Alarm-Siren/Feedback-Box/hardware/Feedback-Box-3Drender-8A-back.jpg

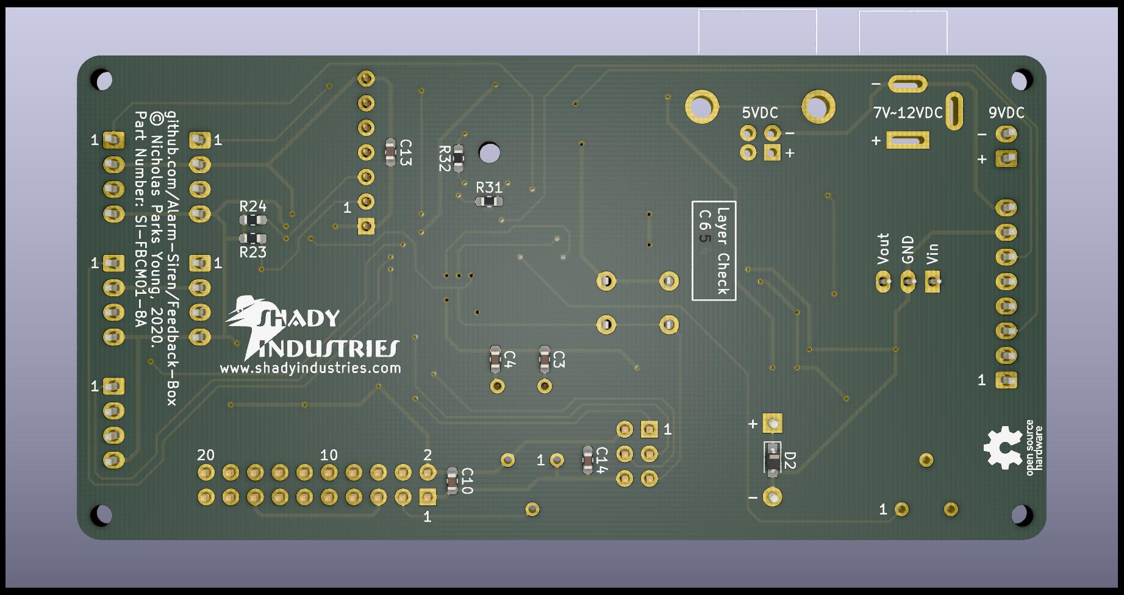
hardware/Feedback-Box-3Drender-8A-back.jpg
