Alarm-Siren/Feedback-Box/hardware/Feedback-Box-3Drender-8A-front.jpg

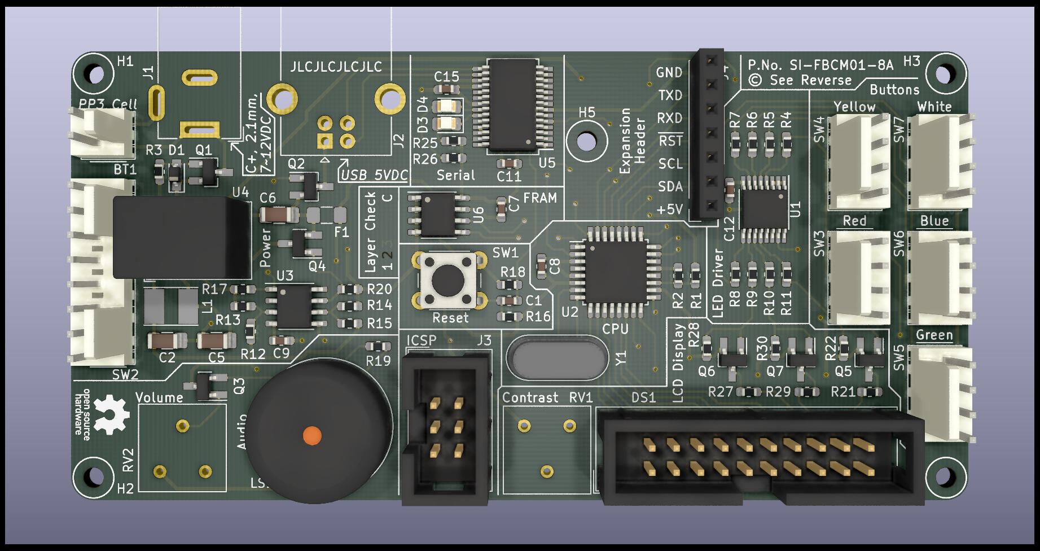
hardware/Feedback-Box-3Drender-8A-front.jpg
