Alarm-Siren/Feedback-Box/hardware/Parts List.xlsx

Reference | Manufacturer | Mft's Part Number | Qty/unit | Total Qty | Price/each (£) | Subtotal (£) | Mouser Part No | Farnell Part No | Misc. Part Link | Footprint | Description
BT1 | Bulgin | BX0023 | 1 | 5 | £4.48 | £22.40 | 122-BX0023 | 1184193 |  | n/a | PP3 (9V) battery holder, panel-mount, black, Flying Leads
BT1a | Molex | 22292021 | 1 | 5 | £0.33 | £1.64 | 538-22-29-2021 | 1360130 |  | Connector_Molex:Molex_KK-254_AE-6410-02A_1x02_P2.54mm_Vertical | Molex KK 254 Series, 2pin header, Wire-to-board, THT
BT1b | Molex | 22013027 | 1 | 5 | £0.06 | £0.32 | 538-22-01-3027 | 1462825 |  | n/a | Molex KK Connector Housing 2pin w/Mating flange & polarizing ribs
BT1c, SW2c | Molex | 08520123 | 44 | 220 | £0.02 | £3.98 | 538-08-52-0101-CT | 2888993 |  | n/a | Molex KK Crimp Contacts, 30-22AWG, Phospher Bronze, Cut Strip
C1, C7-C15 | Wurth Elektronik | 885012206071 | 10 | 50 | £0.03 | £1.40 | 710-885012206071 | 2495173 |  | Capacitor_SMD:C_0603_1608Metric_Pad1.05x0.95mm_HandSolder | Capacitor MLCC 100nF, X7R, 25V, +/-10%, SMD 0603
C2, C6 | Taiyo Yuden | UMK316BBJ106KL-T | 2 | 10 | £0.14 | £1.39 | 963-UMK316BBJ106KL-T |  |  | Capacitor_SMD:C_1206_3216Metric_Pad1.42x1.75mm_HandSolder | Capacitor MLCC 10uF, X5R, 50V, +/-10%, SMD 1206
C3, C4 | AVX | 06035C220JAT2A | 2 | 10 | £0.07 | £0.66 | 581-06035C220JAT2A | 2332643 |  | Capacitor_SMD:C_0603_1608Metric_Pad1.05x0.95mm_HandSolder | Capacitor MLCC 22pF, X7R, 50V, +/-5%, SMD 0603
C5 | Taiyo Yuden | UMK316AB7475KL-T | 1 | 5 | £0.24 | £1.20 | 963-UMK316AB7475KL-T |  |  | Capacitor_SMD:C_1206_3216Metric_Pad1.42x1.75mm_HandSolder | Capacitor MLCC 4.7uF, X7R, 50V, +/-10%, SMD 1206
D1 | ON Semiconductor | MM3Z7V5ST1G | 1 | 5 | £0.09 | £0.46 | 863-MM3Z7V5ST1G | 2441322 |  | Diode_SMD:D_SOD-323_HandSoldering | Single Zener Diode, 7.5V, 300mW, SMD SOD-323
D2 | ON Semiconductor / Fairchild | SS16HE | 1 | 5 | £0.08 | £0.39 | 512-SS16HE | 2822565 |  | Diode_SMD:D_SOD-323_HandSoldering | Schottky Rectifier Diode, Vmax=60V, Imax=1A, Vf=680mV, SMD SOD-323
D3 | Lite-On | LTST-C171KRKT | 1 | 5 | £0.22 | £1.08 | 859-LTST-C171KRKT |  |  | LED_SMD:LED_0805_2012Metric_Pad1.15x1.40mm_HandSolder | Standard Red LED, 55mCD, SMD 0805
D4 | Lite-On | LTST-C171KGKT | 1 | 5 | £0.22 | £1.08 | 859-LTST-C171KGKT |  |  | LED_SMD:LED_0805_2012Metric_Pad1.15x1.40mm_HandSolder | Standard Green LED, 55mCD, SMD 0805
DS1 | Newhaven Displays | NHD-0216K1Z-FS(RGB)-FBW-REV1 | 1 | 5 | £10.55 | £52.75 | 763-0216K1Z-FS-FBWR1 |  |  | n/a | Character LCD 16x2, RGB Backlight, Parallel access, THT
DS1a | Amphenol | T821120A1S100CEU | 1 | 5 | £0.25 | £1.24 |  | 2215309 |  | Connector_IDC:IDC-Header_2x10_P2.54mm_Vertical | IDC Socket 2.54mm pitch, 2x10, Vertical, THT
DS1b | Amphenol | T812120A100CEU | 1 | 5 | £0.23 | £1.15 |  | 2215236 |  | n/a | IDC Plug 2.54mm pitch, 2x10, Vertical
DS1c, SW2a | Molex | 22272081 | 2 | 10 | £0.34 | £3.37 | 538-22-27-2081 | 9731180 |  | Connector_Molex:Molex_KK-254_AE-6410-08A_1x08_P2.54mm_Vertical | Molex KK 254 Series, 8pin header, Wire-to-board, THT
DS1d, SW2b | Molex | 22013087 | 2 | 10 | £0.21 | £2.06 | 538-22-01-3087 | 2396394 |  | n/a | Molex KK Connector Housing 8pin w/Mating flange & polarizing ribs
DS1e | Molex | 22272061 | 1 | 5 | £0.33 | £1.65 | 538-22-27-2061 | 9731172 |  | n/a | Molex KK 254 Series, 6pin header, Wire-to-board, THT
DS1f | Molex | 22013067 | 1 | 5 | £0.19 | £0.96 | 538-22-01-3067 | 1654529 |  | n/a | Molex KK Connector Housing 6pin w/Mating flange & polarizing ribs
F1 | Bel Fuse | 0ZCJ0025AF2E | 1 | 5 | £0.09 | £0.43 | 530-0ZCJ0025AF2E | 2834884 |  | Fuse:Fuse_1206_3216Metric_Pad1.42x1.75mm_HandSolder | PTC Resettable Fuse, Hold 250mA, Trip 500mA, 24VDC, SMD 1206
J1 | Wurth Elektronik | 694106301002 | 1 | 5 | £0.70 | £3.50 | 710-694106301002 | 2472149 |  | Connector_BarrelJack:BarrelJack_Wuerth_6941xx301002 | Barrel Jack Socket, ID 2.1mm, OD 5.5mm, THT
J2 | CUI Devices | UJ2-BH-1-TH | 1 | 5 | £0.42 | £2.09 | 490-UJ2-BH-1-TH |  |  | Connector_USB:USB_B_OST_USB-B1HSxx_Horizontal | USB-B Socket, THT
J3 | Amphenol | T821106A1S100CEU | 1 | 5 | £0.20 | £1.00 |  | 2215302 |  | Connector_IDC:IDC-Header_2x03_P2.54mm_Vertical | IDC Socket 2.54mm pitch, 2x3, Vertical, THT
J4 | Samtec | SSW-107-01-T-S | 1 | 5 | £0.73 | £3.67 | 200-SSW10701TS | 2667434 |  | Connector_PinSocket_2.54mm:PinSocket_1x07_P2.54mm_Vertical | 1x07 2.54mm Square Header Recepticle, Vertical, THT
L1 | RECOM | RLS-126 | 1 | 5 | £0.47 | £2.34 | 919-RLS-126 |  |  | Inductor_SMD:L_Taiyo-Yuden_NR-40xx_HandSoldering | 12uH 0.8A Fixed Inductor, SMD
LS1 | CUI Devices | CVS-1508 | 1 | 5 | £2.29 | £11.45 | 490-CVS-1508 |  |  | Buzzer_Beeper:Buzzer_15x7.5RM7.6 | Loudspeaker, 300mW 8R, D15mm, THT
Q1-Q2, Q4-Q7 | ON Semiconductor / Fairchild | FDN340P | 6 | 30 | £0.26 | £7.68 | 512-FDN340P | 9846310 |  | Package_TO_SOT_SMD:SOT-23_Handsoldering | Mosfet Transistor, P-Channel, 2A, 20V, 0.06R, SMD SOT-23
Q3 | ON Semiconductor | MMBT2222ALT1G | 1 | 5 | £0.10 | £0.51 | 863-MMBT2222ALT1G | 1459098 |  | Package_TO_SOT_SMD:SOT-23_Handsoldering | Bipolar Transistor, NPN, 40V, 300MHz, 225mW, 600mA, SMD SOT-23
R1 | Yageo | RC0603FR-078K2L | 1 | 5 | £0.01 | £0.07 | 603-RC0603FR-078K2L | 9238590 |  | Resistor_SMD:R_0603_1608Metric_Pad1.05x0.95mm_HandSolder | Resistor 8.2kR, 100mW, 75V, +/-1%, SMD 0603
R12, R17, R20, R22, R28, R30 | Yageo | RC0603FR-0768KL | 6 | 30 | £0.01 | £0.42 | 603-RC0603FR-0768KL | 9238700 |  | Resistor_SMD:R_0603_1608Metric_Pad1.05x0.95mm_HandSolder | Resistor 68kR, 100mW, 75V, +/-1%, SMD 0603
R14 | Yageo | RC0603FR-0782KL | 1 | 5 | £0.01 | £0.07 | 603-RC0603FR-0782KL | 9238719 |  | Resistor_SMD:R_0603_1608Metric_Pad1.05x0.95mm_HandSolder | Resistor 82kR, 100mW, 75V, +/-1%, SMD 0603
R16 | Yageo | RC0603FR-0710KL | 1 | 5 | £0.01 | £0.07 | 603-RC0603FR-0710KL | 9238603 |  | Resistor_SMD:R_0603_1608Metric_Pad1.05x0.95mm_HandSolder | Resistor 10kR, 100mW, 75V, +/-1%, SMD 0603
R18, R25-R26, R31-R32 | Yageo | RC0603FR-071KL | 5 | 25 | £0.01 | £0.35 | 603-RC0603FR-071KL | 9238484 |  | Resistor_SMD:R_0603_1608Metric_Pad1.05x0.95mm_HandSolder | Resistor 1kR, 100mW, 75V, +/-1%, SMD 0603
R19 | Yageo | RC1210FR-0762RL | 1 | 5 | £0.12 | £0.61 | 603-RC1210FR-0762RL |  |  | Resistor_SMD:R_1210_3225Metric_Pad1.42x2.65mm_HandSolder | Resistor 62R, 500mW, 75V, +/-1%, SMD 1210
R2 | Yageo | RC0603FR-074K7L | 1 | 5 | £0.01 | £0.07 | 603-RC0603FR-074K7L | 9238565 |  | Resistor_SMD:R_0603_1608Metric_Pad1.05x0.95mm_HandSolder | Resistor 4.7kR, 100mW, 75V, +/-1%, SMD 0603
R23, R24 | Yageo | RC0603FR-073K3L | 2 | 10 | £0.01 | £0.14 | 603-RC0603FR-073K3L | 9238549 |  | Resistor_SMD:R_0603_1608Metric_Pad1.05x0.95mm_HandSolder | Resistor 3.3kR, 100mW, 75V, +/-1%, SMD 0603
R27 | Yageo | RC0603FR-07150RL | 1 | 5 | £0.01 | £0.07 | 603-RC0603FR-07150RL | 9238387 |  | Resistor_SMD:R_0603_1608Metric_Pad1.05x0.95mm_HandSolder | Resistor 150R, 100mW, 75V, +/-1%, SMD 0603
R3, R13, R15 | Yageo | RC0603FR-07100KL | 3 | 15 | £0.01 | £0.21 | 603-RC0603FR-07100KL | 9238727 |  | Resistor_SMD:R_0603_1608Metric_Pad1.05x0.95mm_HandSolder | Resistor 100kR, 100mW, 75V, +/-1%, SMD 0603
R4-R8, R21, R29 | Yageo | RC0603FR-07120RL | 7 | 35 | £0.01 | £0.49 | 603-RC0603FR-07120RL | 9238379 |  | Resistor_SMD:R_0603_1608Metric_Pad1.05x0.95mm_HandSolder | Resistor 120R, 100mW, 75V, +/-1%, SMD 0603
R9-R11 | Yageo | RC0603FR-070RL | 3 | 15 | £0.01 | £0.18 | 603-RC0603FR-070RL | 2309106 |  | Resistor_SMD:R_0603_1608Metric_Pad1.05x0.95mm_HandSolder | Resistor 0R, 100mW, 75V, +/-1%, SMD 0603
RV1-RV2 | Bourns | 3306F-1-103 | 2 | 10 | £0.28 | £2.79 | 652-3306F-1-103 | 1689844 |  | Potentiometer_THT:Potentiometer_Bourns_3386F_Vertical | Trimmer Potentiometer, 10kR, 6mm, 1 turn, Phillips-head, THT
SW1 | Omron | B3W-1000 | 1 | 5 | £0.47 | £2.33 | 653-B3W-1000 | 176986 |  | Button_Switch_THT:SW_PUSH_6mm | 6mm Tactile Switch, THT
SW2 | C&K | Y200AA2C203NQ | 1 | 5 | £12.06 | £60.30 | 611-Y200AA2C203NQ |  |  | n/a | Keylock Switch, DP3T, 4A 125V, Solder Lugs
SW3-SW7 | EG Starts | --- | 5 | 25 | £1.30 | £32.50 |  |  | https://www.amazon.co.uk/EG-Starts-Arcade-Buttons-Multicade/dp/B01N549IDL/ref=sr_1_16 | n/a | Assorted Colours of Illuminated Arcade-style Buttons, Solder Lugs
SW3a-SW7a | Molex | 22272041 | 5 | 25 | £0.24 | £5.92 | 538-22-27-2041 | 9731164 |  | Connector_Molex:Molex_KK-254_AE-6410-04A_1x04_P2.54mm_Vertical | Molex KK 254 Series, 4pin header, Wire-to-board, THT
SW3b-SW7b | Molex | 22013047 | 5 | 25 | £0.11 | £2.65 | 538-22-01-3047 | 2888913 |  | n/a | Molex KK Connector Housing 4pin w/Mating flange & polarizing ribs
U1 | Texas Instruments | TLC59208FIPWR | 1 | 5 | £1.30 | £6.50 | 595-TLC59208FIPWR |  |  | Package_SO:TSSOP-16_4.4x5mm_P0.65mm | LED Controller / Driver, 8 channel, I2C, SMD TSSOP-16
U2 | Microchip / Atmel | ATmega328p-AU | 1 | 5 | £1.50 | £7.50 | 556-ATMEGA328P-AU | 1715486 |  | Package_QFP:TQFP-32_7x7mm_P0.8mm | Microcontroller, 32K flash, 2K ram, SMD TQFP-32
U3 | Texas Instruments | LMV358IDR | 1 | 5 | £0.31 | £1.55 | 595-LMV358IDR | 3117235 |  | Package_SO:SOIC-8_3.9x4.9mm_P1.27mm | Rail-to-Rail Voltage Comparator, SMD SOIC-8
U4 | RECOM | R-78E5.0-0.5 | 1 | 5 | £2.06 | £10.30 | 919-R-78E5.0-0.5 | 2078564 |  | Converter_DCDC:Converter_DCDC_RECOM_R-78E-0.5_THT | DC-DC Voltage Regulator, Switching, Output 5V 500mA, THT
U5 | FTDI | FT232RL-REEL | 1 | 5 | £3.48 | £17.40 | 895-FT232RL | 1146032 |  | Package_SO:SSOP-28_5.3x10.2mm_P0.65mm | USB to Serial Interface IC, SMD SSOP-28
U6 | Cypress Semiconductor | FM24C16B-G | 1 | 5 | £1.24 | £6.20 | 877-FM24C16B-G | 2077748 |  | Package_SO:SOIC-8_3.9x4.9mm_P1.27mm | FRAM, 2KiB, I2C Interface, SMD SOIC-8
Y1 | IQD | LFXTAL027945Reel | 1 | 5 | £0.40 | £2.01 | 449-LFXTAL027945REEL |  |  | Crystal:Crystal_HC49-4H_Vertical | Parallel Crystal, 16MHz, 22pF, THT
 |  |  |  |  | Units Req'd | 5
 |  |  |  |  | Grand Total | £292.57
 |  |  |  |  | Per Unit | £58.51
