Alarm-Siren/Feedback-Box/hardware/Feedback-Box.kicad_pcb

## KiCad design hardware/Feedback-Box.kicad_pcb (2020-08-21)

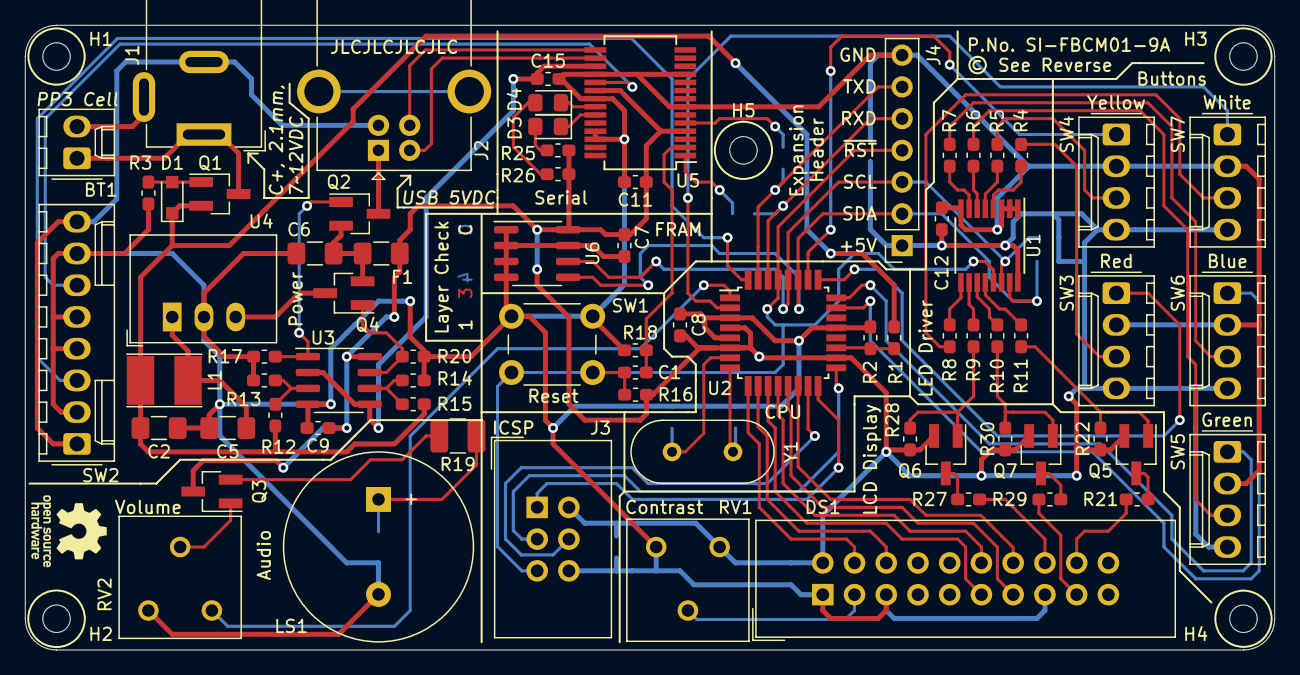
[picture p3: board Feedback-Box.kicad_pcb from above]

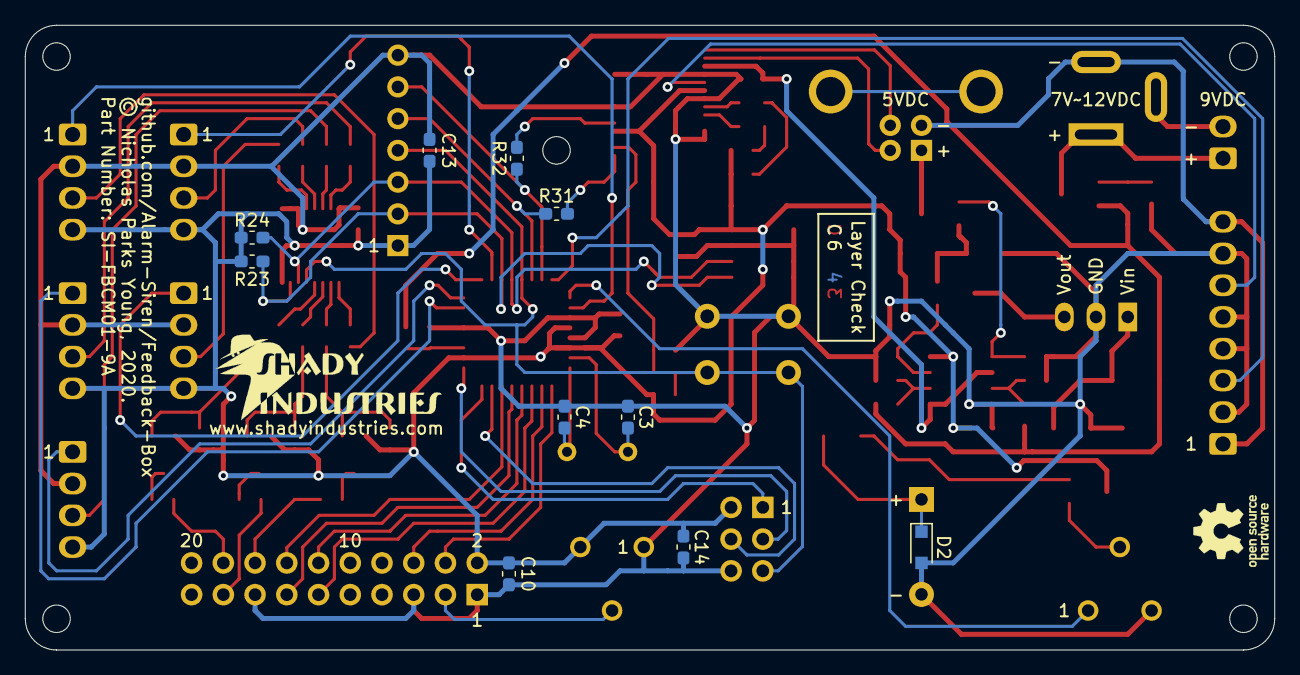
[picture p4: board Feedback-Box.kicad_pcb from below]

Board: 2 copper layers, 100.0 x 50.0 mm, 91 parts (12 on the bottom side), 76 nets.

Parts:
BT1: BX0023; Molex_KK-254_AE-6410-02A_1x02_P2.54mm_Vertical
C1, C7, C8, C9, C10, C11, C12, C13, C14, C15: 100n; C_0603_1608Metric_Pad1.05x0.95mm_HandSolder
C2, C6: 10u; C_1206_3216Metric_Pad1.42x1.75mm_HandSolder
C3, C4: 22p; C_0603_1608Metric_Pad1.05x0.95mm_HandSolder
C5: 4.7u; C_1206_3216Metric_Pad1.42x1.75mm_HandSolder
D1: MM3Z7V5ST1G; D_SOD-323_HandSoldering
D2: SS16HE; D_SOD-323_HandSoldering
D3: LTST-C171KRKT; LED_0805_2012Metric_Pad1.15x1.40mm_HandSolder
D4: LTSTS-C171KGKT; LED_0805_2012Metric_Pad1.15x1.40mm_HandSolder
DS1: NHD-0216K1Z-FS(RGB)-FBW-REV1; IDC-Header_2x10_P2.54mm_Vertical
F1: 0ZCJ0025AF2E; Fuse_1206_3216Metric_Pad1.42x1.75mm_HandSolder
G1: LOGO; SI-Logo-W20.3mm_H8.4mm
G2, G3: OSHW-Logo_5.7x6mm_SilkScreen
H1, H2, H3, H4, H5: MountingHole_2.2mm_M2
J1: 694106301002; BarrelJack_Wuerth_6941xx301002
J2: UJ2-BH-1-TH; USB_B_OST_USB-B1HSxx_Horizontal
J3: T821106A1S100CEU; IDC-Header_2x03_P2.54mm_Vertical
J4: SSW-107-01-T-S; PinSocket_1x07_P2.54mm_Vertical
L1: 12u; L_Taiyo-Yuden_NR-40xx_HandSoldering
LS1: CVS-1508; Buzzer_15x7.5RM7.6
Q1, Q2, Q4, Q5, Q6, Q7: FDN340P; SOT-23_Handsoldering
Q3: MMBT2222ALT1G; SOT-23_Handsoldering
R1: 8.2k; R_0603_1608Metric_Pad1.05x0.95mm_HandSolder
R2: 4.7k; R_0603_1608Metric_Pad1.05x0.95mm_HandSolder
R3, R13, R15: 100k; R_0603_1608Metric_Pad1.05x0.95mm_HandSolder
R4, R5, R6, R7, R8, R21, R29: 120; R_0603_1608Metric_Pad1.05x0.95mm_HandSolder
R9, R10, R11: 0; R_0603_1608Metric_Pad1.05x0.95mm_HandSolder
R12, R17, R20, R22, R28, R30: 68k; R_0603_1608Metric_Pad1.05x0.95mm_HandSolder
R14: 82k; R_0603_1608Metric_Pad1.05x0.95mm_HandSolder
R16: 10k; R_0603_1608Metric_Pad1.05x0.95mm_HandSolder
R18, R25, R26, R31, R32: 1k; R_0603_1608Metric_Pad1.05x0.95mm_HandSolder
R19: 62; R_1210_3225Metric_Pad1.42x2.65mm_HandSolder
R23, R24: 3.3k; R_0603_1608Metric_Pad1.05x0.95mm_HandSolder
R27: 150; R_0603_1608Metric_Pad1.05x0.95mm_HandSolder
RV1, RV2: 10k; Potentiometer_Bourns_3386F_Vertical
SW1: B3W-1000; SW_PUSH_6mm
SW2: Y200AA2C203NQ; Molex_KK-254_AE-6410-08A_1x08_P2.54mm_Vertical
SW3: EG Starts Red; Molex_KK-254_AE-6410-04A_1x04_P2.54mm_Vertical
SW4: EG Starts Yellow; Molex_KK-254_AE-6410-04A_1x04_P2.54mm_Vertical
SW5: EG Starts Green; Molex_KK-254_AE-6410-04A_1x04_P2.54mm_Vertical
SW6: EG Starts Blue; Molex_KK-254_AE-6410-04A_1x04_P2.54mm_Vertical
SW7: EG Starts White; Molex_KK-254_AE-6410-04A_1x04_P2.54mm_Vertical
U1: TLC59208FIPWR; TSSOP-16_4.4x5mm_P0.65mm
U2: ATmega328P-AU; TQFP-32_7x7mm_P0.8mm
U3: LMV358IDR; SOIC-8_3.9x4.9mm_P1.27mm
U4: R-78E5.0-0.5; Converter_DCDC_RECOM_R-78E-0.5_THT
U5: FT232RL; SSOP-28_5.3x10.2mm_P0.65mm
U6: FM24C16B; SOIC-8_3.9x4.9mm_P1.27mm
Y1: 16MHz; Crystal_HC49-4H_Vertical

Connections:
+3V3: C15.1, U3.2, U3.5, U5.17
+5V: C7.1, C8.1, C9.1, C10.1, C11.1, C12.1, C13.1, C14.1, DS1.2, F1.1, J3.2, J4.1, Q3.3, Q5.2, Q6.2, Q7.2, R16.2, R22.2, R23.2, R24.2, R25.1, R26.1, R28.2, R30.2, RV1.3, SW3.4, SW4.4, SW5.4, SW6.4, SW7.4, U1.16, U2.4, U2.6, U2.18, U3.8, U5.4, U5.20, U6.8
/MISO: J3.1, U2.16
/MOSI: J3.4, U2.15
/SCLK: J3.3, U2.17
/XTAL1: C3.2, U2.7, Y1.1
/XTAL2: C4.2, U2.8, Y1.2
/~RXLED: D4.1, U5.22
/~TXLED: D3.1, U5.23
BAT: C2.1, D1.1, L1.1, Q1.2, R1.2, R12.2, R14.2
BTN1: SW3.1, U2.25
BTN2: SW4.1, U2.26
BTN3: SW5.1, U2.24
BTN4: SW6.1, U2.23
BTN5: SW7.1, U2.2
GND: C2.2, C3.1, C4.1, C5.2, C6.2, C7.2, C8.2, C9.2, C10.2, C11.2, C12.2, C13.2, C14.2, C15.2, D2.2, DS1.1, DS1.5, DS1.15, J3.6, J4.7, LS1.2, R2.1, R3.1, R13.1, R15.1, R17.1, R18.1, R20.1, RV1.1, RV2.3, SW1.2, SW2.2, SW2.4, SW2.5, SW2.7, SW3.2, SW4.2, SW5.2, SW6.2, SW7.2, U1.1, U1.2, U1.3, U1.8, U2.3, U2.5, U2.21, U3.4, U4.2, U5.7, U5.11, U5.18, U5.21, U5.25, U5.26, U6.1, U6.2, U6.3, U6.4, U6.7
GNDS: J1.2, J2.4, SW2.1, SW2.8
LCD_D4: DS1.11, U2.11
LCD_D5: DS1.12, U2.12
LCD_D6: DS1.13, U2.13
LCD_D7: DS1.14, U2.14
LCD_E: DS1.6, U2.10
LCD_RS: DS1.4, U2.9
LED1: R4.1, SW3.3
LED2: R5.1, SW4.3
LED3: R6.1, SW5.3
LED4: R7.1, SW6.3
LED5: R8.1, SW7.3
unnamed: BT1.1, J1.1, Q1.3
unnamed: BT1.2, J1.3
unnamed: C5.1, L1.2, U4.1
unnamed: C6.1, F1.2, Q2.2, Q4.2
unnamed: D1.2, Q1.1, R3.2
unnamed: D2.1, LS1.1, R19.1
unnamed: D3.2, R25.2
unnamed: D4.2, R26.2
unnamed: DS1.3, RV1.2
unnamed: J2.1, Q2.3
unnamed: Q2.1, R17.2, U3.1
unnamed: Q3.1, RV2.2
unnamed: Q3.2, R19.2
unnamed: Q4.1, R20.2, U3.7
unnamed: Q4.3, U4.3
unnamed: Q5.3, R21.1
unnamed: Q6.3, R27.1
unnamed: Q7.3, R29.1
unnamed: R1.1, R2.2, U2.19
unnamed: R4.2, U1.4
unnamed: R5.2, U1.5
unnamed: R6.2, U1.6
unnamed: R7.2, U1.7
unnamed: R8.2, U1.9
unnamed: R9.2, U1.10
unnamed: R10.2, U1.11
unnamed: R11.2, U1.12
unnamed: R12.1, R13.2, U3.3
unnamed: R14.1, R15.2, U3.6
unnamed: R31.2, U5.1
unnamed: R32.2, U5.5
PROG~EN: SW2.3, U2.32
RXD: J4.5, R31.1, U2.30
SCL: J4.3, R24.1, U1.14, U2.28, U6.6
SCR_B+: DS1.18, R21.2
SCR_B-: Q5.1, R11.1, R22.1
SCR_G+: DS1.17, R29.2
SCR_G-: Q7.1, R10.1, R30.1
SCR_R+: DS1.16, R27.2
SCR_R-: Q6.1, R9.1, R28.1
SDA: J4.2, R23.1, U1.15, U2.27, U6.5
SPK: RV2.1, U2.1
TXD: J4.6, R32.1, U2.31
USBD+: J2.3, U5.15
USBD-: J2.2, U5.16
USB~RST: SW2.6, U5.19
~DTR: C1.1, R18.2, U5.2
~RST: C1.2, J3.5, J4.4, R16.1, SW1.1, U1.13, U2.29
