Alarm-Siren/Feedback-Box/(commit log)

2020-02-08 Upload initial schematic
    [Feedback-Box.kicad_pcb, Feedback-Box.sch, Parts List.xlsx]
2020-02-09 Started on Hardware Layout
    Power & Loudspeaker sections done. Provisional layout of USB and most connectors also done.
    [Feedback-Box.kicad_pcb, Feedback-Box.sch]
2020-02-09 Labelled up the Power/Audio, routed a bit more power
    [Feedback-Box.kicad_pcb]
2020-02-10 Mostly finished layout, just needs a little final routing
    [Feedback-Box.kicad_pcb]
2020-02-10 Moved "buttons" SS text
    [Feedback-Box.kicad_pcb]
2020-02-12 Finish Layout
    Finished PCB layout;
    Also added another decoupling cap for the ICSP;
    Also added (C) info to schematic + layout;
    Also added Chris' name as "checked by".
    [Feedback-Box.kicad_pcb, Feedback-Box.sch, Parts List.xlsx]
2020-02-14 Added RST+TX+RX to Expansion Header
    Added RST, and Serial TXD/RXD to the Expansion header. To allow TXD/RXD from the FT232RL to be safely 'overriden' by an expansion device, two additional 1K resistors have been fitted as well.
    [Feedback-Box.kicad_pcb, Feedback-Box.sch, Parts List.xlsx]
2020-02-15 Generate gerbers for production
    [Feedback-Box-B_Cu.gbr, Feedback-Box-B_Mask.gbr, Feedback-Box-B_SilkS.gbr, Feedback-Box-Edge_Cuts.gbr, Feedback-Box-F_Cu.gbr, Feedback-Box-F_Mask.gbr, Feedback-Box-F_SilkS.gbr, Feedback-Box-NPTH.drl]
2020-02-23 Correction to Parts List, Starting on Interface Program
    Interface Program now has ability to detect the addition and removal of individual USB Serial devices, and detect their COM Port number and Serial Numbers
    [Parts List.xlsx]
2020-02-25 Layout revision 8B
    Fixed misplaced Pin 1 locator on rear silkscreen for part J4
    [Feedback-Box.kicad_pcb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]
2020-03-13 Update to hardware revision 6C
    Made the drill sizes for the Variable Resistors bigger, because the previous sizes where only *just* big enough.
    [Feedback-Box.kicad_pcb]
2020-03-18 Some very basic firmware to start checking hardware
    [Feedback-Box.sch]
2020-08-21 Switch R19 to 1210, 62R resistor
    This allows the speaker to run at 0.35W instead of the previous 0.11W.
    [Feedback-Box.kicad_pcb, Feedback-Box.sch, Parts List.xlsx]
