Alarm-Siren/Feedback-Box/(notices)

Notices in the files:
hardware/Feedback-Box.sch:
© Nicholas Parks Young, 2020. Some Rights Reserved.
hardware/Feedback-Box.kicad_pcb:
© See Reverse
